analogdevicesinc/m1k-cad/(threads)

Thread 2 (2014-12-08):

increase A4/B4 feedback resistors to decrease load on 2v5 reference

itdaniher, 2014-12-08:
Common mode error is higher than it should be, due in part to the 750o feedback resistors, forcing the reference, even with bias, to drift from 2v5 due to the 1500o||1500o resistor to 5v with maximum output.

itdaniher, 2015-03-05:
MAX6102 is pin&part compatible with the ADR831. If reference U4 is replaced with a MAX6102 component and biasing resistor R183 is depopulated, this issue abates substantially. Changes implemented by both @mbanciso and myself - 2 units locally here in BOS.

itdaniher, 2015-03-05:
"I've done some more thinking about this problem and I think
it comes down to the amount of load current variation that
the 2.5 V regulator can handle is becoming a limit.

400 ohms assumes 20% tolerance on the 750 ohm resistors
450 ohms might be a better compromise. I measured the R183
on my m1ks and it was around 550 ohms so on the high side
near 10% and R24,25 were 720 ohms or so which is on the
low side. Happens to be a bad combination.

The 2.5 V ADR381 can source from 0 to 5mA. The change
in load current due to the 750 ohm resistors around amplifiers
A4 and B4 can be as much as +/- 3.5V/750 or +/- 4.67 mA.
( output of amplifiers can swing from -1 V to +6 V when the
loop is open ) With resistor tolerance this is right at the
current spec of the part. Now add the pull down resistor
to support current sinking 5mA and the part may need to
source nearly 10 mA. Twice the spec.

As your data shows we can't increase the feedback resistors
without causing stability issues. So....."

itdaniher, 2015-04-23:
Implemented upstream. 750 -> 10k.

Closed 2015-04-23.

Thread 3 (2015-02-15):

Rev C shows CHA_2.5V connected to UB11

shabaz123, 2015-02-15:
Hi!
I don't have cadence software, so can only look at PDF schematics. Which is the latest schematic in PDF? I looked in the 'old' folder, and there is a rev C schematic there. I noticed CHA_2.5V is connected to integrated circuit UA11 (as expected),  but also seems to be connected to UB11. Is that intentional?

There is a CHB_5V power signal, but that is not connected to UB11, it only goes to the connector.

I'm guessing the purpose of the CHA_2.5V connection is to allow self-calibration when it is switched in using the digipot?

What is the purpose of the CHB_5V connection? Is it just to be a general purpose connection, not actually related to channel B?

Thanks!

itdaniher, 2015-02-16:
Hello there!

https://github.com/analogdevicesinc/m1k-cad/blob/master/02-037760-01-d-1.pdf is the latest schematic.

The connection from the buffered 2v5 supply to UA11 and UB11 allows the output switches to offer a 50o biasing to the 2.5V virtual ground, switchable onto both channels A and B. This concept is briefly described at https://wiki.analog.com/university/tools/m1k/hw#output_stage - if you can think of better wording, feel free to edit! The 5V supply is simply a buffered / fixed voltage rail.

In short, the connector naming reflects the electrical grouping with regards to the original amplifier - you didn't find a bug, just a hidden (for now) feature.

Regards!
Ian

PS - Allegro Viewer can be grabbed for free from http://www.cadence.com/products/pcb/pages/downloads.aspx, runs fine in a Virtual Machine.

shabaz123, 2015-02-16:
Hi Ian,

Thank you for the information and super-quick response!
Thank you for this great project - very exciting times, exploring with the hardware and software currently!

Closed 2015-02-20.

Thread 4 (2015-02-20):

decrease unprogrammed current consumption

itdaniher, 2015-02-20:
The use of the ADG1611 analog switch on the output stage results in the 5v rail being shorted to ground through resistors when all lines are low, resulting in fairly high quiescent current draw with an unprogrammed device.

A functional enhancement to address this in future revisions would be the replacement of the ADG1611 part with an ADG1612 drop-in replacement, just without the logic inversion.

itdaniher, 2015-04-23:
The upload script should disable the power conversion via the PB17 / PWR_ENABLE pin before it writes to the UC.

rgetz, 2016-02-29:
Which upload script?

itdaniher, 2016-02-29:
The minimal reference implementation / factory load script / upload script mentioned above is https://github.com/analogdevicesinc/m1k-fw/blob/master/scripts/sam-ba.py.

AFAIK Win/OSX don't allow you to explicitly detach a kernel driver, as this script does, which is the recommended way of avoiding issues related to command parsing in the SAMBA ROM. BOSSA works around these issues with sleep()s and is cross platform.

Thread 5 (2015-03-02):

document pixelpulse2 environment modifications for hardware debug

itdaniher, 2015-03-02:
IO can be flipped using:

> session.devices[0].ctrl_transfer(0x50, GPIO, 0) // sets pin GPIO low
> session.devices[0].ctrl_transfer(0x51, GPIO, 0) // sets pin GPIO high

Reference https://github.com/itdaniher/ubuild/blob/master/IO.mkd for IO pinmappings. Add 32 (PORTA offset) to all PortB IO indexes.

> session.devices[0].ctrl_transfer(0x59, 0, 0x7f7f) // sets chA pot to max resistance

@mbanciso hopefully this helps.

itdaniher, 2015-03-05:
I optimised the setpoint voltage for SIMV zero, 4/5 of 32768, at https://github.com/analogdevicesinc/libsmu/commit/bfa3314ebaac27454466e0be98eda4af91aea111. This seems to result in an experimentally minimal bias current in SIMV.

itdaniher, 2015-04-22:
https://github.com/analogdevicesinc/m1k-fw/blob/master/IO.mkd

itdaniher, 2015-04-22:
@damercer see additional thoughts here.

damercer, 2015-04-22:
What am I suppose to look at?

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

itdaniher, 2015-04-22:
@damercer https://github.com/analogdevicesinc/m1k-fw/blob/master/IO.mkd

itdaniher, 2015-04-23:
https://github.com/analogdevicesinc/m1k-fw/blob/master/IO.mkd now describes the control transfers usable to directly manipulate device state.

Closed 2015-04-23.

Thread 6 (2015-05-20):

oscillation when working as current source

vthielen, 2015-05-20:
Hello,

On my device, the output current becomes unstable when I configure the device as current source and short circuit the output to ground.
This happens on both channels. The amplitude of the oscillation increases as the set current goes from +200 to -200 mA.
I included an output file  below (channel 2 set to -100 mA and shorted to ground).
Is this a problem with my device only (and can I trade it for a new one?) Or do I need to make some changes in the feedback loop frequency characteristics?
I saw that there is a digital potentiometer in the loop as well: can it be fixed in software?

Kind Regards,

Bart

0A_Voltage,0A_Current,0B_Voltage,0B_Current
+0.1543,+0.0004,+0.0117,-0.1114
+0.1525,+0.0005,+0.0268,-0.1365
+0.1503,+0.0004,+0.0320,-0.1475
+0.1485,+0.0004,+0.0000,-0.1254
+0.1492,+0.0004,+0.0000,-0.0944
+0.1513,+0.0005,+0.0000,-0.0747
+0.1530,+0.0005,+0.0000,-0.0837
+0.1522,+0.0004,+0.0009,-0.1078
+0.1495,+0.0005,+0.0300,-0.1331
+0.1484,+0.0004,+0.0427,-0.1482
+0.1466,+0.0005,+0.0000,-0.1303
+0.1486,+0.0003,+0.0000,-0.0990
+0.1512,+0.0004,+0.0000,-0.0763
+0.1546,+0.0003,+0.0000,-0.0802
+0.1552,+0.0005,+0.0000,-0.1032
+0.1527,+0.0004,+0.0352,-0.1286
+0.1499,+0.0005,+0.0475,-0.1478
+0.1466,+0.0005,+0.0000,-0.1340
+0.1465,+0.0004,+0.0000,-0.1037
+0.1488,+0.0004,+0.0000,-0.0783
+0.1508,+0.0004,+0.0000,-0.0776
+0.1515,+0.0005,+0.0000,-0.0990
+0.1501,+0.0005,+0.0377,-0.1243
+0.1491,+0.0006,+0.0446,-0.1459
+0.1474,+0.0005,+0.0000,-0.1392
+0.1466,+0.0004,+0.0000,-0.1105
+0.1484,+0.0003,+0.0000,-0.0827
+0.1501,+0.0004,+0.0000,-0.0746
+0.1511,+0.0006,+0.0000,-0.0933
+0.1494,+0.0004,+0.0314,-0.1179
+0.1474,+0.0004,+0.0319,-0.1418
+0.1452,+0.0005,+0.0052,-0.1447
+0.1447,+0.0004,+0.0000,-0.1197
+0.1461,+0.0005,+0.0000,-0.0895
+0.1502,+0.0003,+0.0000,-0.0739
+0.1526,+0.0004,+0.0000,-0.0870
+0.1511,+0.0006,+0.0108,-0.1112
+0.1488,+0.0004,+0.0270,-0.1358
+0.1463,+0.0004,+0.0353,-0.1479
+0.1444,+0.0004,+0.0000,-0.1266
+0.1451,+0.0004,+0.0000,-0.0959
+0.1481,+0.0004,+0.0000,-0.0752
+0.1507,+0.0004,+0.0000,-0.0822
+0.1504,+0.0004,+0.0000,-0.1046
+0.1498,+0.0005,+0.0349,-0.1294
+0.1480,+0.0005,+0.0468,-0.1479
+0.1465,+0.0004,+0.0000,-0.1332
+0.1463,+0.0003,+0.0000,-0.1034
+0.1478,+0.0005,+0.0000,-0.0787
+0.1501,+0.0004,+0.0000,-0.0767
+0.1508,+0.0004,+0.0000,-0.0981
+0.1481,+0.0005,+0.0370,-0.1228
+0.1457,+0.0004,+0.0416,-0.1450
+0.1439,+0.0005,+0.0000,-0.1402
+0.1443,+0.0004,+0.0000,-0.1127
+0.1470,+0.0004,+0.0000,-0.0841
+0.1503,+0.0004,+0.0000,-0.0740
+0.1513,+0.0005,+0.0000,-0.0917
+0.1503,+0.0005,+0.0255,-0.1155
+0.1473,+0.0005,+0.0288,-0.1401
+0.1450,+0.0005,+0.0147,-0.1459
+0.1440,+0.0004,+0.0000,-0.1198
+0.1454,+0.0004,+0.0000,-0.0893
+0.1469,+0.0004,+0.0000,-0.0740
+0.1496,+0.0005,+0.0000,-0.0870
+0.1479,+0.0005,+0.0118,-0.1115
+0.1463,+0.0006,+0.0265,-0.1368
+0.1434,+0.0005,+0.0314,-0.1475
+0.1409,+0.0005,+0.0000,-0.1257
+0.1406,+0.0004,+0.0000,-0.0952
+0.1430,+0.0004,+0.0000,-0.0751
+0.1440,+0.0005,+0.0000,-0.0828
+0.1428,+0.0004,+0.0000,-0.1059
+0.1405,+0.0005,+0.0326,-0.1312
+0.1382,+0.0005,+0.0452,-0.1483
+0.1367,+0.0004,+0.0000,-0.1308
+0.1383,+0.0004,+0.0000,-0.1006
+0.1418,+0.0003,+0.0000,-0.0767
+0.1443,+0.0005,+0.0000,-0.0796
+0.1441,+0.0005,+0.0000,-0.1022
+0.1422,+0.0005,+0.0363,-0.1278
+0.1405,+0.0005,+0.0473,-0.1477
+0.1386,+0.0004,+0.0000,-0.1347
+0.1388,+0.0004,+0.0000,-0.1048
+0.1411,+0.0004,+0.0000,-0.0792
+0.1447,+0.0005,+0.0000,-0.0766
+0.1450,+0.0005,+0.0000,-0.0981
+0.1433,+0.0004,+0.0378,-0.1235
+0.1406,+0.0005,+0.0427,-0.1454
+0.1377,+0.0005,+0.0000,-0.1398
+0.1363,+0.0005,+0.0000,-0.1119
+0.1378,+0.0004,+0.0000,-0.0834
+0.1399,+0.0004,+0.0000,-0.0743
+0.1409,+0.0005,+0.0000,-0.0934
+0.1386,+0.0006,+0.0317,-0.1181
+0.1360,+0.0004,+0.0324,-0.1421
+0.1334,+0.0005,+0.0011,-0.1444
+0.1337,+0.0004,+0.0000,-0.1179
+0.1350,+0.0004,+0.0000,-0.0877
+0.1382,+0.0004,+0.0000,-0.0738
+0.1398,+0.0005,+0.0000,-0.0888
+0.1378,+0.0006,+0.0159,-0.1126
+0.1353,+0.0004,+0.0267,-0.1371
+0.1336,+0.0004,+0.0304,-0.1473
+0.1324,+0.0005,+0.0000,-0.1250
+0.1333,+0.0004,+0.0000,-0.0944
+0.1368,+0.0004,+0.0000,-0.0749
+0.1402,+0.0004,+0.0000,-0.0830
+0.1402,+0.0005,+0.0000,-0.1063
+0.1386,+0.0005,+0.0309,-0.1324
+0.1359,+0.0005,+0.0447,-0.1483
+0.1337,+0.0004,+0.0000,-0.1319
+0.1338,+0.0004,+0.0000,-0.1021
+0.1363,+0.0004,+0.0000,-0.0771
+0.1388,+0.0004,+0.0000,-0.0787
+0.1386,+0.0006,+0.0000,-0.1019
+0.1363,+0.0005,+0.0367,-0.1276
+0.1346,+0.0004,+0.0474,-0.1476
+0.1332,+0.0004,+0.0000,-0.1344
+0.1328,+0.0005,+0.0000,-0.1048
+0.1356,+0.0004,+0.0000,-0.0792
+0.1376,+0.0004,+0.0000,-0.0765
+0.1377,+0.0006,+0.0000,-0.0975
+0.1346,+0.0004,+0.0365,-0.1217
+0.1322,+0.0004,+0.0391,-0.1443
+0.1298,+0.0005,+0.0000,-0.1417
+0.1292,+0.0004,+0.0000,-0.1142
+0.1308,+0.0003,+0.0000,-0.0850
+0.1337,+0.0004,+0.0000,-0.0740
+0.1360,+0.0004,+0.0000,-0.0923
+0.1348,+0.0004,+0.0290,-0.1167
+0.1322,+0.0005,+0.0294,-0.1406
+0.1297,+0.0005,+0.0095,-0.1453
+0.1283,+0.0004,+0.0000,-0.1198
+0.1298,+0.0004,+0.0000,-0.0891
+0.1327,+0.0004,+0.0000,-0.0738
+0.1346,+0.0006,+0.0000,-0.0885
+0.1338,+0.0005,+0.0160,-0.1126
+0.1325,+0.0004,+0.0267,-0.1376
+0.1316,+0.0004,+0.0246,-0.1469
+0.1308,+0.0004,+0.0000,-0.1232
+0.1327,+0.0004,+0.0000,-0.0933
+0.1352,+0.0004,+0.0000,-0.0746
+0.1377,+0.0004,+0.0000,-0.0834
+0.1368,+0.0004,+0.0004,-0.1074
+0.1347,+0.0005,+0.0313,-0.1317
+0.1322,+0.0005,+0.0452,-0.1482
+0.1304,+0.0005,+0.0000,-0.1316
+0.1305,+0.0004,+0.0000,-0.1011
+0.1331,+0.0004,+0.0000,-0.0771
+0.1352,+0.0004,+0.0000,-0.0790
+0.1351,+0.0005,+0.0000,-0.1016
+0.1330,+0.0005,+0.0367,-0.1266
+0.1303,+0.0004,+0.0469,-0.1471
+0.1276,+0.0004,+0.0000,-0.1364
+0.1260,+0.0004,+0.0000,-0.1065
+0.1278,+0.0003,+0.0000,-0.0797
+0.1300,+0.0004,+0.0000,-0.0763
+0.1302,+0.0005,+0.0000,-0.0972
+0.1279,+0.0005,+0.0372,-0.1221
+0.1250,+0.0004,+0.0405,-0.1448
+0.1229,+0.0005,+0.0000,-0.1410
+0.1229,+0.0003,+0.0000,-0.1132
+0.1242,+0.0004,+0.0000,-0.0839
+0.1263,+0.0004,+0.0000,-0.0742
+0.1276,+0.0005,+0.0000,-0.0924
+0.1255,+0.0005,+0.0296,-0.1172
+0.1228,+0.0004,+0.0301,-0.1412
+0.1206,+0.0005,+0.0066,-0.1450
+0.1199,+0.0005,+0.0000,-0.1189
+0.1224,+0.0004,+0.0000,-0.0883
+0.1255,+0.0003,+0.0000,-0.0737
+0.1276,+0.0005,+0.0000,-0.0893
+0.1264,+0.0005,+0.0197,-0.1136
+0.1248,+0.0005,+0.0272,-0.1384
+0.1221,+0.0005,+0.0253,-0.1470
+0.1210,+0.0005,+0.0000,-0.1233
+0.1218,+0.0003,+0.0000,-0.0928
+0.1244,+0.0004,+0.0000,-0.0745
+0.1266,+0.0005,+0.0000,-0.0835
+0.1261,+0.0004,+0.0000,-0.1070
+0.1247,+0.0006,+0.0307,-0.1326
+0.1221,+0.0005,+0.0438,-0.1481
+0.1203,+0.0005,+0.0000,-0.1307
+0.1205,+0.0004,+0.0000,-0.1006
+0.1228,+0.0002,+0.0000,-0.0768
+0.1247,+0.0005,+0.0000,-0.0794
+0.1233,+0.0006,+0.0000,-0.1021
+0.1215,+0.0007,+0.0365,-0.1272
+0.1193,+0.0004,+0.0467,-0.1471
+0.1173,+0.0005,+0.0000,-0.1368
+0.1176,+0.0004,+0.0000,-0.1068
+0.1207,+0.0005,+0.0000,-0.0799
+0.1238,+0.0004,+0.0000,-0.0759
+0.1242,+0.0005,+0.0000,-0.0966
+0.1223,+0.0005,+0.0360,-0.1211
+0.1197,+0.0006,+0.0385,-0.1441
+0.1172,+0.0004,+0.0000,-0.1416
+0.1163,+0.0004,+0.0000,-0.1142
+0.1176,+0.0004,+0.0000,-0.0849
+0.1214,+0.0004,+0.0000,-0.0741
+0.1231,+0.0004,+0.0000,-0.0919
+0.1215,+0.0005,+0.0286,-0.1165
+0.1195,+0.0006,+0.0296,-0.1408
+0.1173,+0.0005,+0.0106,-0.1453
+0.1160,+0.0004,+0.0000,-0.1194
+0.1169,+0.0005,+0.0000,-0.0891
+0.1191,+0.0004,+0.0000,-0.0738
+0.1207,+0.0005,+0.0000,-0.0877
+0.1189,+0.0004,+0.0127,-0.1117
+0.1173,+0.0005,+0.0269,-0.1364
+0.1150,+0.0005,+0.0315,-0.1476
+0.1147,+0.0003,+0.0000,-0.1256
+0.1160,+0.0004,+0.0000,-0.0948
+0.1192,+0.0004,+0.0000,-0.0747
+0.1218,+0.0005,+0.0000,-0.0835
+0.1211,+0.0005,+0.0000,-0.1071
+0.1186,+0.0005,+0.0309,-0.1320
+0.1159,+0.0005,+0.0443,-0.1481
+0.1140,+0.0005,+0.0000,-0.1308
+0.1142,+0.0005,+0.0000,-0.1005
+0.1173,+0.0003,+0.0000,-0.0768
+0.1199,+0.0005,+0.0000,-0.0796
+0.1200,+0.0004,+0.0000,-0.1028
+0.1185,+0.0005,+0.0363,-0.1280
+0.1164,+0.0005,+0.0469,-0.1476
+0.1142,+0.0005,+0.0000,-0.1350
+0.1145,+0.0004,+0.0000,-0.1048
+0.1163,+0.0005,+0.0000,-0.0786
+0.1189,+0.0004,+0.0000,-0.0774
+0.1189,+0.0005,+0.0000,-0.0989
+0.1172,+0.0005,+0.0374,-0.1238
+0.1150,+0.0005,+0.0429,-0.1455
+0.1137,+0.0004,+0.0000,-0.1395
+0.1137,+0.0005,+0.0000,-0.1111
+0.1166,+0.0004,+0.0000,-0.0824
+0.1192,+0.0005,+0.0000,-0.0749
+0.1205,+0.0006,+0.0000,-0.0949
+0.1180,+0.0004,+0.0349,-0.1201
+0.1157,+0.0005,+0.0350,-0.1430
+0.1125,+0.0004,+0.0000,-0.1432
+0.1119,+0.0004,+0.0000,-0.1165
+0.1137,+0.0003,+0.0000,-0.0862
+0.1167,+0.0004,+0.0000,-0.0739
+0.1188,+0.0004,+0.0000,-0.0906
+0.1172,+0.0005,+0.0252,-0.1154
+0.1150,+0.0006,+0.0283,-0.1399
+0.1131,+0.0005,+0.0162,-0.1459
+0.1122,+0.0005,+0.0000,-0.1207
+0.1135,+0.0004,+0.0000,-0.0898
+0.1155,+0.0004,+0.0000,-0.0739
+0.1178,+0.0005,+0.0000,-0.0866
+0.1164,+0.0004,+0.0083,-0.1103
+0.1145,+0.0007,+0.0271,-0.1357
+0.1127,+0.0004,+0.0343,-0.1478
+0.1116,+0.0004,+0.0000,-0.1263
+0.1117,+0.0003,+0.0000,-0.0956
+0.1144,+0.0004,+0.0000,-0.0748
+0.1170,+0.0004,+0.0000,-0.0832
+0.1159,+0.0005,+0.0000,-0.1066
+0.1138,+0.0005,+0.0316,-0.1314
+0.1112,+0.0005,+0.0452,-0.1480
+0.1089,+0.0004,+0.0000,-0.1313
+0.1096,+0.0004,+0.0000,-0.1003
+0.1124,+0.0004,+0.0000,-0.0765
+0.1152,+0.0005,+0.0000,-0.0799
+0.1146,+0.0005,+0.0000,-0.1032
+0.1125,+0.0004,+0.0358,-0.1282
+0.1106,+0.0005,+0.0472,-0.1476
+0.1087,+0.0004,+0.0000,-0.1352
+0.1080,+0.0004,+0.0000,-0.1055
+0.1090,+0.0004,+0.0000,-0.0792
+0.1118,+0.0005,+0.0000,-0.0767
+0.1119,+0.0004,+0.0000,-0.0984
+0.1099,+0.0004,+0.0372,-0.1231
+0.1085,+0.0004,+0.0410,-0.1449
+0.1061,+0.0005,+0.0000,-0.1403
+0.1065,+0.0004,+0.0000,-0.1122
+0.1082,+0.0004,+0.0000,-0.0837
+0.1110,+0.0004,+0.0000,-0.0743
+0.1115,+0.0005,+0.0000,-0.0928
+0.1096,+0.0004,+0.0298,-0.1173
+0.1063,+0.0005,+0.0311,-0.1413
+0.1035,+0.0005,+0.0054,-0.1449
+0.1023,+0.0004,+0.0000,-0.1184
+0.1038,+0.0004,+0.0000,-0.0880
+0.1066,+0.0004,+0.0000,-0.0737
+0.1090,+0.0005,+0.0000,-0.0886
+0.1073,+0.0004,+0.0149,-0.1123
+0.1060,+0.0004,+0.0266,-0.1368
+0.1036,+0.0005,+0.0288,-0.1473
+0.1022,+0.0003,+0.0000,-0.1250
+0.1025,+0.0004,+0.0000,-0.0941
+0.1058,+0.0004,+0.0000,-0.0747
+0.1080,+0.0005,+0.0000,-0.0832
+0.1077,+0.0005,+0.0000,-0.1063
+0.1061,+0.0005,+0.0320,-0.1314
+0.1041,+0.0006,+0.0449,-0.1482
+0.1019,+0.0005,+0.0000,-0.1307
+0.1026,+0.0004,+0.0000,-0.1006
+0.1048,+0.0004,+0.0000,-0.0768
+0.1068,+0.0005,+0.0000,-0.0793
+0.1052,+0.0004,+0.0000,-0.1028
+0.1026,+0.0005,+0.0361,-0.1280
+0.0996,+0.0005,+0.0470,-0.1476
+0.0979,+0.0004,+0.0000,-0.1348
+0.0977,+0.0003,+0.0000,-0.1045
+0.1009,+0.0004,+0.0000,-0.0785
+0.1038,+0.0003,+0.0000,-0.0773
+0.1037,+0.0005,+0.0000,-0.0987
+0.1017,+0.0004,+0.0374,-0.1238
+0.1003,+0.0005,+0.0429,-0.1453
+0.0980,+0.0004,+0.0000,-0.1403
+0.0971,+0.0004,+0.0000,-0.1124
+0.0986,+0.0005,+0.0000,-0.0834
+0.1010,+0.0004,+0.0000,-0.0743
+0.1033,+0.0005,+0.0000,-0.0929
+0.1015,+0.0004,+0.0308,-0.1176
+0.0990,+0.0005,+0.0313,-0.1416
+0.0962,+0.0005,+0.0044,-0.1447
+0.0952,+0.0003,+0.0000,-0.1184
+0.0958,+0.0004,+0.0000,-0.0888
+0.0974,+0.0005,+0.0000,-0.0738
+0.0982,+0.0004,+0.0000,-0.0888
+0.0954,+0.0005,+0.0179,-0.1132
+0.0921,+0.0005,+0.0276,-0.1387
+0.0893,+0.0004,+0.0208,-0.1465
+0.0879,+0.0003,+0.0000,-0.1220
+0.0893,+0.0003,+0.0000,-0.0914
+0.0918,+0.0004,+0.0000,-0.0742
+0.0937,+0.0005,+0.0000,-0.0852
+0.0929,+0.0004,+0.0043,-0.1091
+0.0909,+0.0004,+0.0275,-0.1347
+0.0880,+0.0005,+0.0391,-0.1482
+0.0859,+0.0003,+0.0000,-0.1276
+0.0863,+0.0005,+0.0000,-0.0968
+0.0883,+0.0004,+0.0000,-0.0753
+0.0909,+0.0004,+0.0000,-0.0820
+0.0905,+0.0005,+0.0000,-0.1050
+0.0889,+0.0006,+0.0340,-0.1297
+0.0871,+0.0005,+0.0465,-0.1480
+0.0848,+0.0004,+0.0000,-0.1325
+0.0850,+0.0004,+0.0000,-0.1029
+0.0867,+0.0004,+0.0000,-0.0780
+0.0883,+0.0004,+0.0000,-0.0783
+0.0871,+0.0005,+0.0000,-0.1008
+0.0842,+0.0004,+0.0372,-0.1258
+0.0815,+0.0005,+0.0458,-0.1466
+0.0794,+0.0004,+0.0000,-0.1367
+0.0796,+0.0004,+0.0000,-0.1080
+0.0823,+0.0005,+0.0000,-0.0807
+0.0854,+0.0005,+0.0000,-0.0758
+0.0867,+0.0006,+0.0000,-0.0966
+0.0851,+0.0006,+0.0367,-0.1218
+0.0832,+0.0005,+0.0402,-0.1447
+0.0814,+0.0005,+0.0000,-0.1407
+0.0811,+0.0003,+0.0000,-0.1127
+0.0839,+0.0003,+0.0000,-0.0837
+0.0875,+0.0004,+0.0000,-0.0742
+0.0903,+0.0006,+0.0000,-0.0926
+0.0894,+0.0004,+0.0272,-0.1163
+0.0884,+0.0004,+0.0295,-0.1405
+0.0869,+0.0004,+0.0108,-0.1454
+0.0864,+0.0005,+0.0000,-0.1198
+0.0876,+0.0004,+0.0000,-0.0891
+0.0901,+0.0004,+0.0000,-0.0738
+0.0916,+0.0006,+0.0000,-0.0883
+0.0900,+0.0005,+0.0150,-0.1122
+0.0871,+0.0005,+0.0269,-0.1374
+0.0848,+0.0005,+0.0281,-0.1470
+0.0835,+0.0004,+0.0000,-0.1247
+0.0851,+0.0004,+0.0000,-0.0941
+0.0874,+0.0005,+0.0000,-0.0746
+0.0899,+0.0004,+0.0000,-0.0838
+0.0886,+0.0004,+0.0000,-0.1073
+0.0865,+0.0004,+0.0300,-0.1329
+0.0833,+0.0005,+0.0430,-0.1481
+0.0813,+0.0005,+0.0000,-0.1302
+0.0811,+0.0004,+0.0000,-0.1002
+0.0841,+0.0004,+0.0000,-0.0769
+0.0864,+0.0004,+0.0000,-0.0795
+0.0866,+0.0004,+0.0000,-0.1023
+0.0854,+0.0005,+0.0369,-0.1270
+0.0836,+0.0004,+0.0467,-0.1471
+0.0814,+0.0004,+0.0000,-0.1361
+0.0819,+0.0004,+0.0000,-0.1065
+0.0845,+0.0003,+0.0000,-0.0798
+0.0872,+0.0005,+0.0000,-0.0761
+0.0884,+0.0005,+0.0000,-0.0976
+0.0872,+0.0005,+0.0371,-0.1232
+0.0859,+0.0004,+0.0433,-0.1455
+0.0846,+0.0005,+0.0000,-0.1393
+0.0850,+0.0004,+0.0000,-0.1112
+0.0876,+0.0004,+0.0000,-0.0827
+0.0906,+0.0005,+0.0000,-0.0746
+0.0907,+0.0005,+0.0000,-0.0941
+0.0883,+0.0004,+0.0336,-0.1191
+0.0848,+0.0004,+0.0346,-0.1429
+0.0819,+0.0005,+0.0000,-0.1427
+0.0804,+0.0004,+0.0000,-0.1149
+0.0818,+0.0004,+0.0000,-0.0846
+0.0844,+0.0004,+0.0000,-0.0741
+0.0867,+0.0004,+0.0000,-0.0925
+0.0857,+0.0005,+0.0293,-0.1170
+0.0842,+0.0005,+0.0306,-0.1411
+0.0820,+0.0005,+0.0061,-0.1450
+0.0813,+0.0004,+0.0000,-0.1186
+0.0825,+0.0006,+0.0000,-0.0879
+0.0854,+0.0004,+0.0000,-0.0738
+0.0866,+0.0005,+0.0000,-0.0888
+0.0847,+0.0005,+0.0176,-0.1131
+0.0823,+0.0005,+0.0267,-0.1381
+0.0802,+0.0004,+0.0266,-0.1470
+0.0790,+0.0005,+0.0000,-0.1240
+0.0800,+0.0004,+0.0000,-0.0929
+0.0834,+0.0004,+0.0000,-0.0745
+0.0852,+0.0005,+0.0000,-0.0842
+0.0849,+0.0005,+0.0018,-0.1082
+0.0822,+0.0005,+0.0288,-0.1338
+0.0803,+0.0005,+0.0409,-0.1481
+0.0790,+0.0003,+0.0000,-0.1284
+0.0803,+0.0004,+0.0000,-0.0972
+0.0830,+0.0004,+0.0000,-0.0756
+0.0864,+0.0004,+0.0000,-0.0818
+0.0860,+0.0005,+0.0000,-0.1052
+0.0845,+0.0005,+0.0325,-0.1308
+0.0815,+0.0004,+0.0458,-0.1480
+0.0791,+0.0005,+0.0000,-0.1322
+0.0784,+0.0005,+0.0000,-0.1027
+0.0809,+0.0004,+0.0000,-0.0778
+0.0832,+0.0003,+0.0000,-0.0780
+0.0833,+0.0005,+0.0000,-0.1009
+0.0811,+0.0005,+0.0373,-0.1259
+0.0797,+0.0004,+0.0464,-0.1467
+0.0781,+0.0004,+0.0000,-0.1373
+0.0793,+0.0004,+0.0000,-0.1075
+0.0819,+0.0003,+0.0000,-0.0806
+0.0845,+0.0005,+0.0000,-0.0756
+0.0856,+0.0006,+0.0000,-0.0964
+0.0835,+0.0005,+0.0360,-0.1210
+0.0815,+0.0005,+0.0377,-0.1439
+0.0800,+0.0004,+0.0000,-0.1420
+0.0795,+0.0003,+0.0000,-0.1143
+0.0805,+0.0003,+0.0000,-0.0851
+0.0837,+0.0004,+0.0000,-0.0739
+0.0859,+0.0005,+0.0000,-0.0910
+0.0852,+0.0006,+0.0254,-0.1155
+0.0842,+0.0005,+0.0292,-0.1404
+0.0818,+0.0005,+0.0120,-0.1456
+0.0809,+0.0004,+0.0000,-0.1202
+0.0826,+0.0004,+0.0000,-0.0892
+0.0856,+0.0004,+0.0000,-0.0739
+0.0874,+0.0004,+0.0000,-0.0877
+0.0852,+0.0006,+0.0153,-0.1124
+0.0830,+0.0005,+0.0268,-0.1373
+0.0816,+0.0004,+0.0292,-0.1472
+0.0801,+0.0006,+0.0000,-0.1245
+0.0805,+0.0004,+0.0000,-0.0932
+0.0829,+0.0004,+0.0000,-0.0745
+0.0856,+0.0006,+0.0000,-0.0848
+0.0836,+0.0004,+0.0004,-0.1074
+0.0819,+0.0004,+0.0313,-0.1320
+0.0799,+0.0005,+0.0442,-0.1482
+0.0784,+0.0005,+0.0000,-0.1304
+0.0787,+0.0004,+0.0000,-0.1001
+0.0824,+0.0005,+0.0000,-0.0767
+0.0861,+0.0005,+0.0000,-0.0797
+0.0869,+0.0005,+0.0000,-0.1025
+0.0855,+0.0005,+0.0365,-0.1274
+0.0829,+0.0005,+0.0470,-0.1473
+0.0806,+0.0004,+0.0000,-0.1363
+0.0800,+0.0003,+0.0000,-0.1066
+0.0816,+0.0004,+0.0000,-0.0792
+0.0838,+0.0005,+0.0000,-0.0771
+0.0835,+0.0005,+0.0000,-0.0989
+0.0810,+0.0006,+0.0375,-0.1238
+0.0786,+0.0005,+0.0430,-0.1455
+0.0767,+0.0005,+0.0000,-0.1393
+0.0770,+0.0005,+0.0000,-0.1107
+0.0788,+0.0003,+0.0000,-0.0819
+0.0818,+0.0004,+0.0000,-0.0749
+0.0819,+0.0006,+0.0000,-0.0945
+0.0810,+0.0004,+0.0330,-0.1188
+0.0791,+0.0004,+0.0340,-0.1426
+0.0774,+0.0004,+0.0000,-0.1437
+0.0771,+0.0004,+0.0000,-0.1173
+0.0803,+0.0003,+0.0000,-0.0873
+0.0840,+0.0004,+0.0000,-0.0738
+0.0867,+0.0005,+0.0000,-0.0893
+0.0855,+0.0005,+0.0189,-0.1134
+0.0837,+0.0005,+0.0269,-0.1382
+0.0808,+0.0005,+0.0233,-0.1467
+0.0797,+0.0005,+0.0000,-0.1232
+0.0798,+0.0005,+0.0000,-0.0931
+0.0828,+0.0005,+0.0000,-0.0745
+0.0848,+0.0004,+0.0000,-0.0847
+0.0832,+0.0004,+0.0030,-0.1086
+0.0816,+0.0005,+0.0298,-0.1333
+0.0803,+0.0005,+0.0428,-0.1482
+0.0790,+0.0004,+0.0000,-0.1295
+0.0797,+0.0005,+0.0000,-0.0990
+0.0827,+0.0004,+0.0000,-0.0760
+0.0850,+0.0004,+0.0000,-0.0807
+0.0848,+0.0005,+0.0000,-0.1040
+0.0827,+0.0006,+0.0348,-0.1294
+0.0811,+0.0005,+0.0470,-0.1478
+0.0792,+0.0004,+0.0000,-0.1342
+0.0803,+0.0004,+0.0000,-0.1042
+0.0826,+0.0004,+0.0000,-0.0783
+0.0864,+0.0005,+0.0000,-0.0777
+0.0870,+0.0005,+0.0000,-0.1000
+0.0851,+0.0005,+0.0375,-0.1246
+0.0823,+0.0004,+0.0443,-0.1459
+0.0800,+0.0005,+0.0000,-0.1388
+0.0792,+0.0004,+0.0000,-0.1102
+0.0813,+0.0004,+0.0000,-0.0821
+0.0837,+0.0004,+0.0000,-0.0750
+0.0855,+0.0005,+0.0000,-0.0956
+0.0838,+0.0004,+0.0354,-0.1204
+0.0822,+0.0005,+0.0359,-0.1434
+0.0794,+0.0004,+0.0000,-0.1430
+0.0793,+0.0004,+0.0000,-0.1165
+0.0801,+0.0004,+0.0000,-0.0871
+0.0820,+0.0005,+0.0000,-0.0738
+0.0829,+0.0005,+0.0000,-0.0890
+0.0810,+0.0005,+0.0175,-0.1130
+0.0785,+0.0005,+0.0265,-0.1371
+0.0756,+0.0005,+0.0283,-0.1472
+0.0742,+0.0004,+0.0000,-0.1238
+0.0753,+0.0005,+0.0000,-0.0934
+0.0784,+0.0004,+0.0000,-0.0744
+0.0809,+0.0004,+0.0000,-0.0842
+0.0800,+0.0004,+0.0006,-0.1076
+0.0782,+0.0005,+0.0310,-0.1325
+0.0757,+0.0004,+0.0423,-0.1482
+0.0728,+0.0005,+0.0000,-0.1288
+0.0729,+0.0004,+0.0000,-0.0985
+0.0748,+0.0004,+0.0000,-0.0760
+0.0765,+0.0004,+0.0000,-0.0807
+0.0755,+0.0005,+0.0000,-0.1039
+0.0742,+0.0005,+0.0355,-0.1285
+0.0713,+0.0004,+0.0470,-0.1478
+0.0689,+0.0004,+0.0000,-0.1340
+0.0689,+0.0004,+0.0000,-0.1044
+0.0706,+0.0004,+0.0000,-0.0784
+0.0727,+0.0005,+0.0000,-0.0774
+0.0735,+0.0004,+0.0000,-0.0993
+0.0717,+0.0005,+0.0375,-0.1241
+0.0702,+0.0005,+0.0449,-0.1461
+0.0684,+0.0004,+0.0000,-0.1389
+0.0687,+0.0003,+0.0000,-0.1101
+0.0709,+0.0003,+0.0000,-0.0817
+0.0731,+0.0005,+0.0000,-0.0750
+0.0735,+0.0005,+0.0000,-0.0942
+0.0718,+0.0004,+0.0338,-0.1192
+0.0694,+0.0005,+0.0341,-0.1428
+0.0659,+0.0005,+0.0000,-0.1434
+0.0652,+0.0003,+0.0000,-0.1160
+0.0666,+0.0005,+0.0000,-0.0855
+0.0703,+0.0004,+0.0000,-0.0739
+0.0731,+0.0005,+0.0000,-0.0907
+0.0724,+0.0005,+0.0247,-0.1153
+0.0711,+0.0005,+0.0275,-0.1389
+0.0700,+0.0005,+0.0226,-0.1465
+0.0687,+0.0004,+0.0000,-0.1230
+0.0696,+0.0003,+0.0000,-0.0925
+0.0716,+0.0004,+0.0000,-0.0742
+0.0739,+0.0004,+0.0000,-0.0852
+0.0723,+0.0006,+0.0031,-0.1086
+0.0715,+0.0004,+0.0296,-0.1332
+0.0698,+0.0005,+0.0428,-0.1483
+0.0702,+0.0004,+0.0000,-0.1295
+0.0711,+0.0004,+0.0000,-0.0991
+0.0745,+0.0005,+0.0000,-0.0763
+0.0780,+0.0004,+0.0000,-0.0806
+0.0788,+0.0003,+0.0000,-0.1035
+0.0767,+0.0005,+0.0350,-0.1288
+0.0752,+0.0005,+0.0469,-0.1477
+0.0729,+0.0005,+0.0000,-0.1341
+0.0729,+0.0003,+0.0000,-0.1038
+0.0755,+0.0003,+0.0000,-0.0784
+0.0788,+0.0005,+0.0000,-0.0770
+0.0797,+0.0005,+0.0000,-0.0986
+0.0784,+0.0004,+0.0373,-0.1234
+0.0763,+0.0005,+0.0435,-0.1457
+0.0747,+0.0004,+0.0000,-0.1392
+0.0742,+0.0004,+0.0000,-0.1101
+0.0768,+0.0004,+0.0000,-0.0822
+0.0797,+0.0005,+0.0000,-0.0746
+0.0816,+0.0004,+0.0000,-0.0941
+0.0805,+0.0005,+0.0321,-0.1182
+0.0792,+0.0006,+0.0327,-0.1420
+0.0771,+0.0005,+0.0004,-0.1442
+0.0767,+0.0004,+0.0000,-0.1180
+0.0784,+0.0004,+0.0000,-0.0881
+0.0805,+0.0006,+0.0000,-0.0737
+0.0823,+0.0005,+0.0000,-0.0892
+0.0801,+0.0005,+0.0178,-0.1132
+0.0778,+0.0005,+0.0263,-0.1374
+0.0748,+0.0003,+0.0307,-0.1474
+0.0735,+0.0004,+0.0000,-0.1250
+0.0757,+0.0004,+0.0000,-0.0939
+0.0794,+0.0005,+0.0000,-0.0747
+0.0824,+0.0005,+0.0000,-0.0844
+0.0813,+0.0005,+0.0014,-0.1078
+0.0793,+0.0005,+0.0301,-0.1327
+0.0771,+0.0005,+0.0430,-0.1480
+0.0749,+0.0004,+0.0000,-0.1306
+0.0750,+0.0005,+0.0000,-0.0999
+0.0776,+0.0004,+0.0000,-0.0767
+0.0802,+0.0004,+0.0000,-0.0797
+0.0803,+0.0005,+0.0000,-0.1025
+0.0782,+0.0006,+0.0364,-0.1272
+0.0779,+0.0006,+0.0471,-0.1472
+0.0769,+0.0005,+0.0000,-0.1354
+0.0777,+0.0004,+0.0000,-0.1060
+0.0806,+0.0005,+0.0000,-0.0790
+0.0837,+0.0005,+0.0000,-0.0770
+0.0834,+0.0005,+0.0000,-0.0983
+0.0809,+0.0004,+0.0377,-0.1237
+0.0777,+0.0005,+0.0425,-0.1453
+0.0754,+0.0004,+0.0000,-0.1398
+0.0755,+0.0004,+0.0000,-0.1121
+0.0780,+0.0004,+0.0000,-0.0831
+0.0815,+0.0004,+0.0000,-0.0744

Thread 7 (2019-04-29):

Revision F Schematic?

damercer, 2019-04-29:
Since the Revision F of the board is now selling maybe we should post the F schematic and whatever other design files, BOM etc?

Thanks

Doug

damercer, 2020-06-07:
How about some progress on this???

Doug

greyltc, 2021-02-19:
Would be really great to see.
@itdaniher any chance can you comment on this?

greyltc, 2021-02-19:
Or maybe @damercer, could you help out here?

damercer, 2021-02-19:
I don't have an official production copy of version F. Maybe Mihai Bancisor can supply this.

rgetz, 2021-02-19:
I will take the action - sorry - We just forgot to update things here...

zrnsm, 2021-10-03:
@rgetz @damercer Just bumping this thread again to express my interest in having a copy of the Rev. F cad assets. Thank you.
