analogdevicesinc/m1k-cad/gerbers/art_param.txt

DEVICE-TYPE           GERBER_RS274X
OUTPUT-UNITS          INCHES
FILM-SIZE             3600000 2400000
FORMAT                5.5
ABORT-ON-ERROR        YES
SCALE                 1
SUPPRESS-LEAD-ZEROES  YES
SUPPRESS-TRAIL-ZEROES NO
SUPPRESS-EQUAL        YES
UNDEF-APT-CONT        NO
