analogdevicesinc/m1k-cad/gerbers/nc_param.txt

INTEGER-PLACES         2
DECIMAL-PLACES         4
X-OFFSET               0.000000
Y-OFFSET               0.000000
FEEDRATE               1
COORDINATES            ABSOLUTE
OUTPUT-UNITS           ENGLISH
TOOL-ORDER             INCREASING
REPEAT-CODES           YES
SUPPRESS-LEAD-ZEROES   NO
SUPPRESS-TRAIL-ZEROES  NO
SUPPRESS-EQUAL         NO
TOOL-SELECT            YES
OPTIMIZE_DRILLING      NO
ENHANCED_EXCELLON      NO
TAPE-FILE              C:/tmp/20_037760d/worklib/02_037760d_top/physical/ncdrill.drl
HEADER                 08_037760d
LEADER                 12
CODE                   ASCII
SEPARATE               NO
DRILLING               LAYER-PAIR
BACKDRILL              YES
CAVITY                 NO
