analogdevicesinc/m1k-cad/(commit log)

2014-11-12 add schematics
2014-11-12 add BOM
    [BOM.csv]
2014-11-12 add PCB CAD in native and gerber formats
    [08_037760d.brd, art_param.txt, nc_param.txt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]
2015-01-06 update ecad / art
    [08_037760d.brd]
2015-03-30 drop old schematics
2015-05-15 map analog improvements to BOM changes
    [BOM.csv]
2015-05-15 remove leading column
    [BOM.csv]
